bdash/williams-system-9-displays/Williams System 9 display.kicad_pcb

## KiCad design Williams System 9 display.kicad_pcb (2023-09-08)

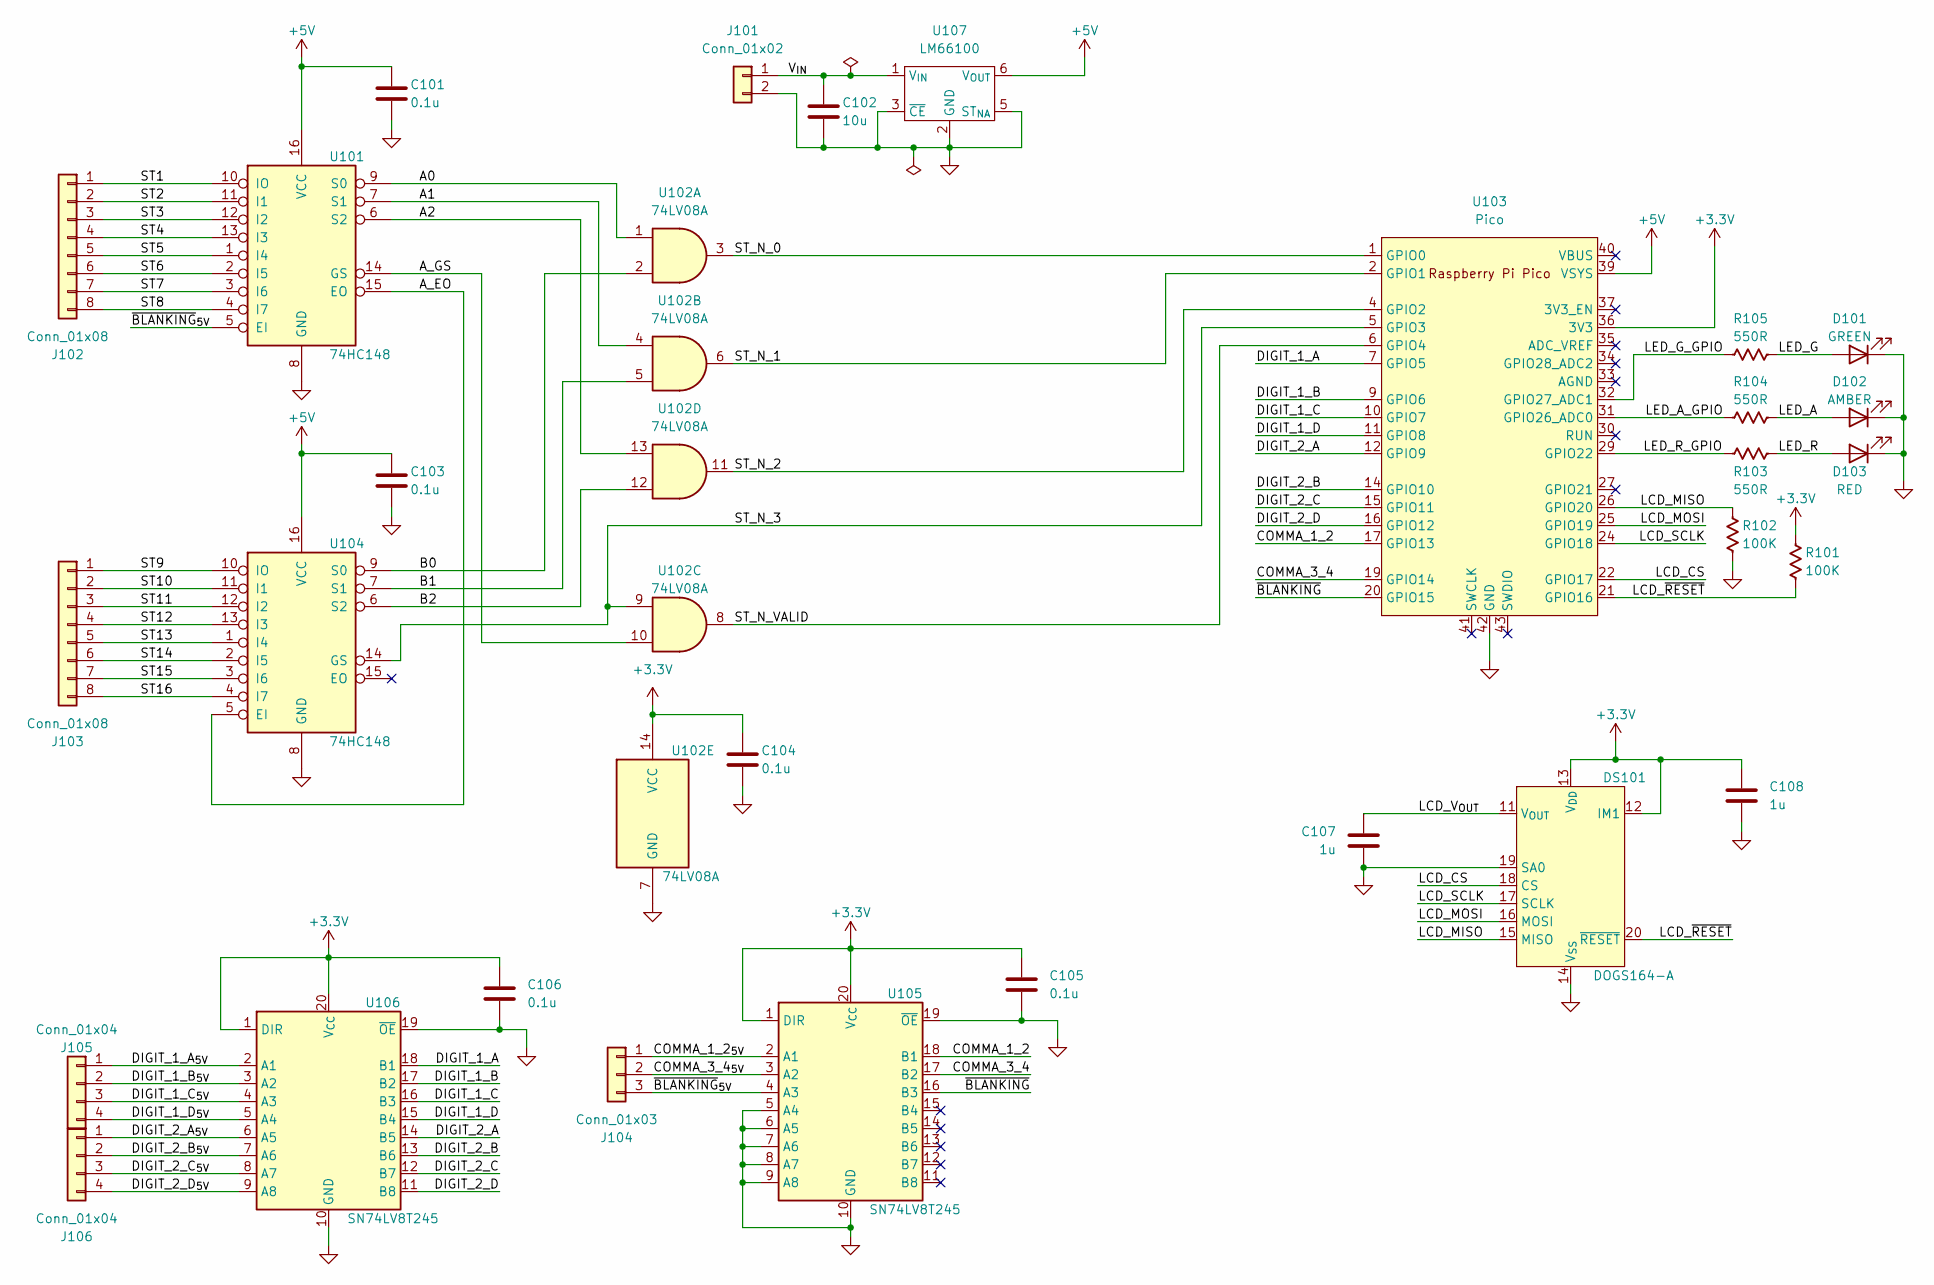
[picture p1: schematic Williams System 9 display.kicad_sch]

Parts:
C101, C103, C104, C105, C106: 0.1u; C_0805_2012Metric_Pad1.18x1.45mm_HandSolder
C102: 10u; C_0805_2012Metric_Pad1.18x1.45mm_HandSolder
C107, C108: 1u; C_0805_2012Metric_Pad1.18x1.45mm_HandSolder
D101: GREEN; D_1206_3216Metric_Pad1.42x1.75mm_HandSolder; MPN LTST-C150GKT
D102: AMBER; D_1206_3216Metric_Pad1.42x1.75mm_HandSolder; MPN LTST-C150AKT
D103: RED; D_1206_3216Metric_Pad1.42x1.75mm_HandSolder; MPN LTST-C150EKT
DS101: DOGS164-A; EA_DOGS164X-A
J101: Conn_01x02; PinHeader_1x02_P2.54mm_Vertical
J102, J103: Conn_01x08; PinHeader_1x08_P2.54mm_Vertical
J104: Conn_01x03; PinHeader_1x03_P2.54mm_Vertical
J105, J106: Conn_01x04; PinHeader_1x04_P2.54mm_Vertical
R101, R102: 100K; R_0805_2012Metric_Pad1.15x1.40mm_HandSolder
R103, R104, R105: 550R; R_0805_2012Metric_Pad1.15x1.40mm_HandSolder
U101, U104: 74HC148; DIP-16_W7.62mm; MPN SN74HC148N
U102: 74LV08A; TSSOP-14_4.4x5mm_P0.65mm; MPN 74LV08AT14-13
U103: Pico; RPi_Pico_SMD_TH
U105, U106: SN74LV8T245; TSSOP-20_4.4x6.5mm_P0.65mm
U107: LM66100; SOT-363_SC-70-6_Handsoldering

Connections:
+3.3V: C104.1, C105.1, C106.1, C108.1, DS101.12 (IM1), DS101.13 (V_{DD}), R101.1, U102.14 (VCC), U103.36 (3V3), U105.1 (DIR), U105.20 (V_{CC}), U106.1 (DIR), U106.20 (V_{CC})
+5V: C101.1, C103.1, U101.16 (VCC), U103.39 (VSYS), U104.16 (VCC), U107.6 (V_{OUT})
/A0: U101.9 (S0), U102.1
/A1: U101.7 (S1), U102.4
/A2: U101.6 (S2), U102.13
/A_EO: U101.15 (EO), U104.5 (EI)
/A_GS: U101.14 (GS), U102.10
/B0: U102.2, U104.9 (S0)
/B1: U102.5, U104.7 (S1)
/B2: U102.12, U104.6 (S2)
/COMMA_1_2: U103.17 (GPIO13), U105.18 (B1)
/COMMA_1_2_{5V}: J104.1, U105.2 (A1)
/COMMA_3_4: U103.19 (GPIO14), U105.17 (B2)
/COMMA_3_4_{5V}: J104.2, U105.3 (A2)
/DIGIT_1_A: U103.7 (GPIO5), U106.18 (B1)
/DIGIT_1_A_{5V}: J105.1, U106.2 (A1)
/DIGIT_1_B: U103.9 (GPIO6), U106.17 (B2)
/DIGIT_1_B_{5V}: J105.2, U106.3 (A2)
/DIGIT_1_C: U103.10 (GPIO7), U106.16 (B3)
/DIGIT_1_C_{5V}: J105.3, U106.4 (A3)
/DIGIT_1_D: U103.11 (GPIO8), U106.15 (B4)
/DIGIT_1_D_{5V}: J105.4, U106.5 (A4)
/DIGIT_2_A: U103.12 (GPIO9), U106.14 (B5)
/DIGIT_2_A_{5V}: J106.1, U106.6 (A5)
/DIGIT_2_B: U103.14 (GPIO10), U106.13 (B6)
/DIGIT_2_B_{5V}: J106.2, U106.7 (A6)
/DIGIT_2_C: U103.15 (GPIO11), U106.12 (B7)
/DIGIT_2_C_{5V}: J106.3, U106.8 (A7)
/DIGIT_2_D: U103.16 (GPIO12), U106.11 (B8)
/DIGIT_2_D_{5V}: J106.4, U106.9 (A8)
/LCD_CS: DS101.18 (CS), U103.22 (GPIO17)
/LCD_MISO: DS101.15 (MISO), R102.1, U103.26 (GPIO20)
/LCD_MOSI: DS101.16 (MOSI), U103.25 (GPIO19)
/LCD_SCLK: DS101.17 (SCLK), U103.24 (GPIO18)
/LCD_V_{OUT}: C107.1, DS101.11 (V_{OUT})
/LCD_~RESET: DS101.20 (~RESET), R101.2, U103.21 (GPIO16)
/LED_A: D102.2 (A), R104.2
/LED_A_GPIO: R104.1, U103.31 (GPIO26_ADC0)
/LED_G: D101.2 (A), R105.2
/LED_G_GPIO: R105.1, U103.32 (GPIO27_ADC1)
/LED_R: D103.2 (A), R103.2
/LED_R_GPIO: R103.1, U103.29 (GPIO22)
/ST1: J102.1, U101.10 (IO)
/ST2: J102.2, U101.11 (I1)
/ST3: J102.3, U101.12 (I2)
/ST4: J102.4, U101.13 (I3)
/ST5: J102.5, U101.1 (I4)
/ST6: J102.6, U101.2 (I5)
/ST7: J102.7, U101.3 (I6)
/ST8: J102.8, U101.4 (I7)
/ST9: J103.1, U104.10 (IO)
/ST10: J103.2, U104.11 (I1)
/ST11: J103.3, U104.12 (I2)
/ST12: J103.4, U104.13 (I3)
/ST13: J103.5, U104.1 (I4)
/ST14: J103.6, U104.2 (I5)
/ST15: J103.7, U104.3 (I6)
/ST16: J103.8, U104.4 (I7)
/ST_N_0: U102.3, U103.1 (GPIO0)
/ST_N_1: U102.6, U103.2 (GPIO1)
/ST_N_2: U102.11, U103.4 (GPIO2)
/ST_N_3: U102.9, U103.5 (GPIO3), U104.14 (GS)
/ST_N_VALID: U102.8, U103.6 (GPIO4)
/V_{IN}: C102.1, J101.1, U107.1 (V_{IN})
/~BLANKING: U103.20 (GPIO15), U105.16 (B3)
/~BLANKING_{5V}: J104.3, U101.5 (EI), U105.4 (A3)
GND: C101.2, C102.2, C103.2, C104.2, C105.2, C106.2, C107.2, C108.2, D101.1 (K), D102.1 (K), D103.1 (K), DS101.14 (V_{SS}), DS101.19 (SA0), J101.2, R102.2, U101.8 (GND), U102.7 (GND), U103.3 (GND), U103.8 (GND), U103.13 (GND), U103.18 (GND), U103.23 (GND), U103.28 (GND), U103.38 (GND), U103.42 (GND), U104.8 (GND), U105.5 (A4), U105.6 (A5), U105.7 (A6), U105.8 (A7), U105.9 (A8), U105.10 (GND), U105.19 (~OE), U106.10 (GND), U106.19 (~OE), U107.2 (GND), U107.3 (~CE), U107.5 (ST_{NA})

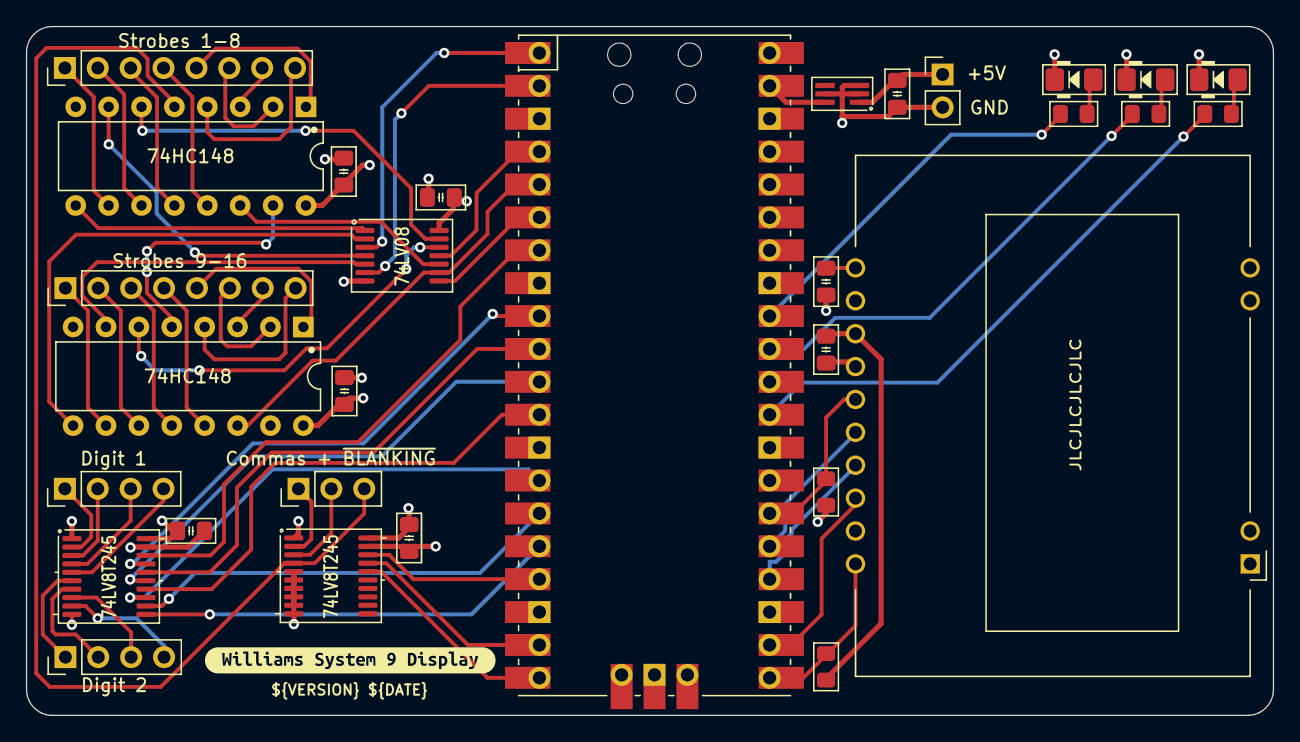
[picture p2: board Williams System 9 display.kicad_pcb from above]

Board: 4 copper layers, 96.3 x 53.2 mm, 31 parts (0 on the bottom side), 67 nets.

Other parts of the board:
kibuzzard-64FB800B: G***; kibuzzard-64FB800B
