bdash/williams-system-9-displays/(commit log)

2023-09-08 Initial version, mostly complete
    [Williams System 9 display.kicad_pcb, Williams System 9 display.kicad_sch]
2023-09-08 Switch to using a submodule for personal component library
2023-09-08 Make AKL available via personal component library for ease of integration
    [Williams System 9 display.kicad_sch]
2023-09-08 Address the remaining ERC violations
    [Williams System 9 display.kicad_pcb, Williams System 9 display.kicad_sch]
2023-09-08 Address the remaining DRC violations by updating two footprints to match the library
    [Williams System 9 display.kicad_pcb]
2023-09-08 Trying using the latest git version of KiBot to see if it can avoid KiCad 7 bugs
2023-09-08 Try specifying a container of kicad7_auto_full:dev
2023-09-08 Rounded rect for PCB edge cut
    [Williams System 9 display.kicad_pcb]
2023-09-08 Disable auto-scaling for pcb_print to work around KiBot exception
2023-09-08 More informative silkscreen
    [Williams System 9 display.kicad_pcb, Williams System 9 display.kicad_sch]
2023-09-18 Group all SPI writes for a packet into a single operation
2023-09-18 Initial version of code that works with real board
    It successfully interprets display data, but output has some tearing and there are occasional errors in displayed values. Both require further investigation.
    [system-9-displays.cpp]
2023-09-18 Don't use BLANKING as enable signal for priority encoder since it is of the wrong polarity
    [Williams System 9 display.kicad_sch]
2023-09-19 LM66100 should be filled
    [Williams System 9 display.kicad_sch]
